TAconsel/TS2/README.md

# TS2 — USB audio on a Cyclone 10 LP FPGA

A USB Audio Class playback device built from scratch on a 10CL006YE144C8G core
board: a USB3300 ULPI PHY on one side, a PCM5102A DAC over I2S on the other,
and a full USB device stack in VHDL in between — ULPI bus master, serial
interface engine, high-speed chirp negotiation, control endpoint, descriptors,
isochronous audio sink and an asynchronous feedback loop.

**USB high speed, 384 kHz, 32-bit stereo.** The host sees
`1209:0001 TS2 USB Audio` and ALSA opens it at `s32le 2ch 384000Hz`. The I2S
framing is generic — 24-bit by default, which is what a PCM5102A accepts and
all it can resolve; full 32-bit is one constant away for a DAC that wants it.
With nothing streaming the DAC is fed silence, with the clocks still running so
it stays locked; `IDLE_TONE` on `ts2_top` puts a 1 kHz test tone there instead
for bring-up.

Uses 52% of the logic and 32% of the memory on a 10CL006, about a third of
that debug scaffolding.

See **[USB_AUDIO.md](USB_AUDIO.md)** for the design, the debugging tools, and
an account of what the bring-up turned up.

## Quick start

```sh
scripts/build.sh               # Quartus compile, with a timing summary
scripts/prog.sh                # load over the USB Blaster
scripts/sim.sh                 # both testbenches under GHDL
debug/usb_trace.py --follow    # live status over the board's CH340
```

## Wiring

| Signal | FPGA pin | |
| --- | --- | --- |
| FPGA_CLK | 91 | 50 MHz TCXO |
| LED | 100 | |
| PCM5102A DIN / LCK / BCK / SCK | 1 / 3 / 143 / 141 | SCK held low: BCK-only mode |
| USB3300 DATA0..7 | 31 32 33 34 38 39 42 43 | |
| USB3300 STP / NXT / DIR / CLK / RST | 44 / 46 / 49 / 23 / 51 | CLK is a dedicated clock input |
| FPGA_TX | 11 | debug trace, 1 Mbaud, on the on-board CH340 |

The USB3300 module needs its own 3.3 V; the common breakouts do not regulate
it from VBUS, so the OTG cable alone will not power it. It must be plugged
into a high-speed port: 384 kHz stereo at four bytes a sample does not fit a
full-speed frame.
