TAconsel/TS2/(commit log)

2026-09-05 USB Audio Class device on Cyclone 10 LP: full speed, 48 kHz 16-bit stereo
    A complete USB device stack in VHDL driving a PCM5102A over I2S, with a
    USB3300 ULPI PHY. Enumerates as 1209:0001 and delivers samples to the DAC
    bit-exact, with zero dropped packets and an asynchronous feedback loop holding
    the rate against the board's 48000.53 Hz audio clock.
    ulpi.vhd ULPI bus master: registers, packets, CRC16
    usb_sie.vhd packet and transaction layer, control endpoint
    usb_device.vhd PHY setup + master + SIE
    usb_audio.vhd isochronous sink, clock crossing, feedback loop
    usb_top.vhd PHY clock search, status trace, bus capture
    usb_desc.vhd generated by scrip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
2026-09-05 USB high speed, 384 kHz 32-bit stereo
    Attaches at full speed and negotiates up: on a bus reset the device answers
    with a chirp K, watches for the host to chirp back, and switches to high-speed
    termination if it does. Register settings for each step come from the USB3300
    datasheet's DP/DM termination table. 384 kHz stereo at four bytes a sample is
    3.07 MB/s, which does not fit a full-speed frame at all.
    The audio clock is now 128 x Fs from a 173/176 PLL ratio, giving 383966.62 Hz.
    Being 87 ppm off 384000 costs nothing: the device is asynchronous and reports
    the rate it actually runs at, so the host follows it. The stream is 32-bit and
    the top 24 bits reach the DAC, which is all a 64 x Fs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
    [audio_pll.vhd, i2s_master.vhd, i2s_monitor.vhd, tb_usb_audio.vhd, tb_usb_device.vhd]
2026-09-05 Carry the full 32-bit sample to the I2S bus
    Philips I2S spends the first bit time of each slot on the format's one-clock
    delay, so a 32-bit word does not fit a 32-bit slot: 64 x Fs carries 24-bit
    audio and 32-bit audio not at all. Sending all 32 means 64 bit clocks per
    channel, which puts BCK at 128 x Fs = 49.1 MHz and the audio clock at
    256 x Fs = 98.3 MHz -- a 173/88 PLL ratio, same VCO as before. Fs is
    unchanged at 383966.62 Hz.
    The word length and frame size are now generics on ts2_top, passed to
    i2s_master and i2s_monitor together, so a DAC that wants the 64-bit-clock
    frame is one constant away:
    SLOT_BITS / DATA_BITS = 64 / 32 full 32-bit, BCK 49.1 MHz (default)
    SLOT_BITS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
    [audio_pll.vhd, i2s_master.vhd, i2s_monitor.vhd, tb_usb_audio.vhd, ts2_top.vhd]
2026-09-05 Default back to 24-bit I2S; add left-justified for full 32-bit
    The 128 x Fs frame produced no sound on the PCM5102A. The waveform was
    correct -- the JTAG monitor, which re-decodes the bus the way the DAC does,
    reported 383966 Hz, clean framing and values matching the source -- but the
    part works its format out from the BCK/LRCK ratio and takes 32, 48 or 64 bit
    clocks a frame, not 128. So the default goes back to 24-bit I2S at 64 x Fs,
    and the audio clock back to 128 x Fs = 49.147727 MHz.
    Left-justified framing is added, which is the better way to get a full 32-bit
    word into a part like this: it spends no bit time on a leading delay, so 32
    bits fit a 32-bit slot at the original bit clock.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
    [audio_pll.vhd, i2s_master.vhd, i2s_monitor.vhd, tb_usb_audio.vhd, ts2_top.vhd]
2026-09-05 Feed the DAC silence when nothing is streaming
    The 1 kHz test tone was there so that an idle board proved itself alive before
    there was any USB to play through it. Now that there is, a converter sitting
    and humming is just a nuisance, so idle is silence and the tone lives behind
    IDLE_TONE on ts2_top for bring-up.
    The bit clock and word clock keep running either way, so the DAC stays locked
    and audio resumes without a thump; only the data goes to zero. With the tone
    off the generator and its sine table are not built at all, which is the 3840
    bits the memory total drops by.
    The I2S decoder no longer treats the absent tone as an inconsistency: with
    IDLE_TONE off, or while USB audio is playi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
    [ts2_top.vhd]
